calvinhlin/IMSSDC2024/PCB/Full/phi2_50MHz_EPC2214/render.png

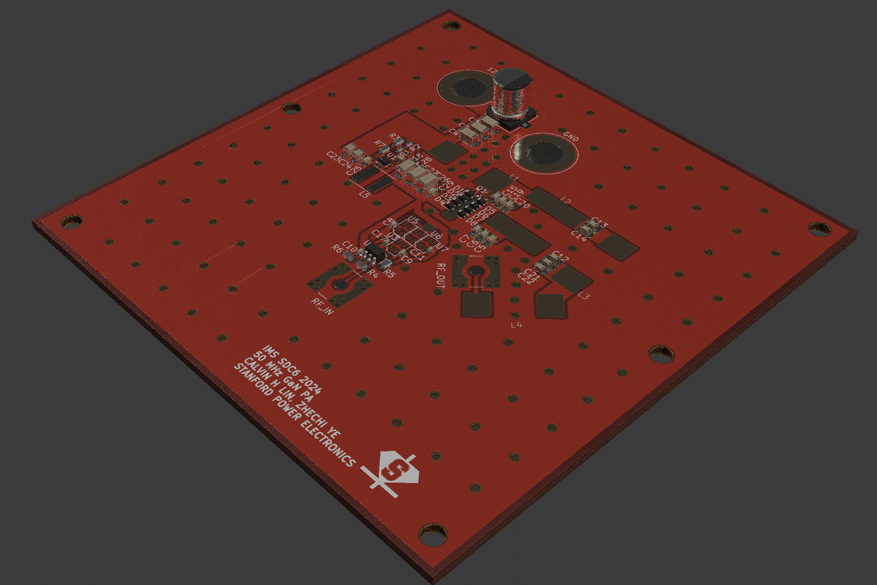
PCB/Full/phi2_50MHz_EPC2214/render.png
