calvinhlin/IMSSDC2024/Measurement Data/GaN_thermal.pdf

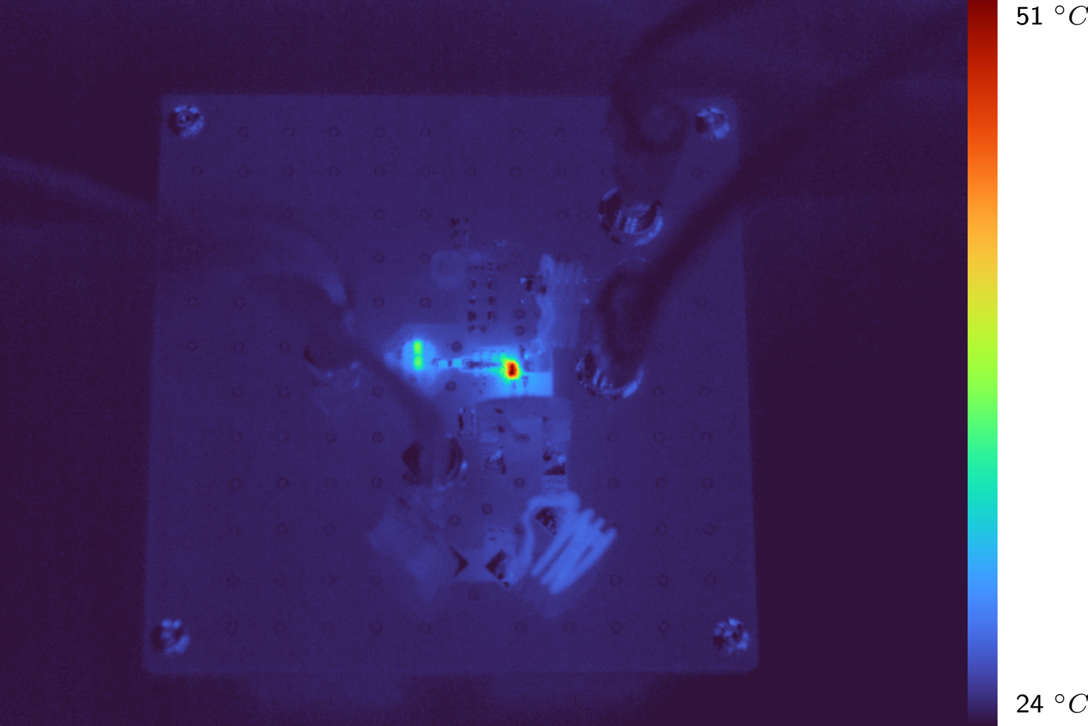
[picture p15: page 1]

24 ◦C

51 ◦C
