calvinhlin/IMSSDC2024/Measurement Data/ims24drain_rev2.csv

3.13E-07 | 2.44E+01
3.13E-07 | 2.43E+01
3.13E-07 | 2.43E+01
3.13E-07 | 2.42E+01
3.13E-07 | 2.42E+01
3.13E-07 | 2.41E+01
3.13E-07 | 2.41E+01
3.13E-07 | 2.40E+01
3.13E-07 | 2.40E+01
3.13E-07 | 2.39E+01
3.13E-07 | 2.38E+01
3.13E-07 | 2.38E+01
3.13E-07 | 2.37E+01
3.13E-07 | 2.36E+01
3.13E-07 | 2.35E+01
3.13E-07 | 2.35E+01
3.13E-07 | 2.34E+01
3.13E-07 | 2.33E+01
3.13E-07 | 2.31E+01
3.13E-07 | 2.30E+01
3.13E-07 | 2.29E+01
3.13E-07 | 2.27E+01
3.13E-07 | 2.26E+01
3.13E-07 | 2.24E+01
3.13E-07 | 2.22E+01
3.13E-07 | 2.21E+01
3.13E-07 | 2.19E+01
3.13E-07 | 2.17E+01
3.13E-07 | 2.15E+01
3.13E-07 | 2.13E+01
3.13E-07 | 2.12E+01
3.13E-07 | 2.10E+01
3.13E-07 | 2.09E+01
3.13E-07 | 2.07E+01
3.13E-07 | 2.06E+01
3.13E-07 | 2.04E+01
3.13E-07 | 2.03E+01
3.13E-07 | 2.02E+01
3.13E-07 | 2.01E+01
3.13E-07 | 2.00E+01
3.13E-07 | 1.99E+01
3.13E-07 | 1.98E+01
3.13E-07 | 1.97E+01
3.13E-07 | 1.96E+01
3.13E-07 | 1.96E+01
3.13E-07 | 1.95E+01
3.13E-07 | 1.95E+01
3.13E-07 | 1.95E+01
3.13E-07 | 1.94E+01
3.13E-07 | 1.94E+01
3.13E-07 | 1.94E+01
3.13E-07 | 1.94E+01
3.13E-07 | 1.93E+01
3.13E-07 | 1.93E+01
3.13E-07 | 1.93E+01
3.13E-07 | 1.92E+01
3.13E-07 | 1.92E+01
3.13E-07 | 1.91E+01
3.13E-07 | 1.91E+01
3.13E-07 | 1.90E+01
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
