calvinhlin/IMSSDC2024/Measurement Data/ims24gate_rev2.csv

3.13E-07 | -6.83E-01 | 0.00E+00
3.13E-07 | -6.62E-01 | 3.12E-12
3.13E-07 | -6.49E-01 | 6.25E-12
3.13E-07 | -6.30E-01 | 9.37E-12
3.13E-07 | -6.20E-01 | 1.25E-11
3.13E-07 | -6.04E-01 | 1.56E-11
3.13E-07 | -5.88E-01 | 1.87E-11
3.13E-07 | -5.78E-01 | 2.19E-11
3.13E-07 | -5.65E-01 | 2.50E-11
3.13E-07 | -5.51E-01 | 2.81E-11
3.13E-07 | -5.44E-01 | 3.12E-11
3.13E-07 | -5.30E-01 | 3.44E-11
3.13E-07 | -5.30E-01 | 3.75E-11
3.13E-07 | -5.25E-01 | 4.06E-11
3.13E-07 | -5.22E-01 | 4.37E-11
3.13E-07 | -5.12E-01 | 4.69E-11
3.13E-07 | -5.12E-01 | 5.00E-11
3.13E-07 | -5.12E-01 | 5.31E-11
3.13E-07 | -5.12E-01 | 5.62E-11
3.13E-07 | -5.12E-01 | 5.94E-11
3.13E-07 | -5.17E-01 | 6.25E-11
3.13E-07 | -5.15E-01 | 6.56E-11
3.13E-07 | -5.17E-01 | 6.87E-11
3.13E-07 | -5.22E-01 | 7.19E-11
3.13E-07 | -5.20E-01 | 7.50E-11
3.13E-07 | -5.30E-01 | 7.81E-11
3.13E-07 | -5.33E-01 | 8.12E-11
3.13E-07 | -5.38E-01 | 8.44E-11
3.13E-07 | -5.44E-01 | 8.75E-11
3.13E-07 | -5.44E-01 | 9.06E-11
3.13E-07 | -5.49E-01 | 9.37E-11
3.13E-07 | -5.49E-01 | 9.69E-11
3.13E-07 | -5.49E-01 | 1.00E-10
3.13E-07 | -5.57E-01 | 1.03E-10
3.13E-07 | -5.57E-01 | 1.06E-10
3.13E-07 | -5.59E-01 | 1.09E-10
3.13E-07 | -5.59E-01 | 1.12E-10
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
