calvinhlin/IMSSDC2024/Measurement Data/ims24output_rev2.csv

3.13E-07 | -2.69E+01
3.13E-07 | -2.68E+01
3.13E-07 | -2.68E+01
3.13E-07 | -2.67E+01
3.13E-07 | -2.67E+01
3.13E-07 | -2.66E+01
3.13E-07 | -2.65E+01
3.13E-07 | -2.65E+01
3.13E-07 | -2.64E+01
3.13E-07 | -2.63E+01
3.13E-07 | -2.63E+01
3.13E-07 | -2.62E+01
3.13E-07 | -2.62E+01
3.13E-07 | -2.62E+01
3.13E-07 | -2.62E+01
3.13E-07 | -2.62E+01
3.13E-07 | -2.62E+01
3.13E-07 | -2.62E+01
3.13E-07 | -2.62E+01
3.13E-07 | -2.62E+01
3.13E-07 | -2.63E+01
3.13E-07 | -2.63E+01
3.13E-07 | -2.64E+01
3.13E-07 | -2.65E+01
3.13E-07 | -2.65E+01
3.13E-07 | -2.66E+01
3.13E-07 | -2.67E+01
3.13E-07 | -2.68E+01
3.13E-07 | -2.69E+01
3.13E-07 | -2.70E+01
3.13E-07 | -2.70E+01
3.13E-07 | -2.71E+01
3.13E-07 | -2.72E+01
3.13E-07 | -2.72E+01
3.13E-07 | -2.73E+01
3.13E-07 | -2.73E+01
3.13E-07 | -2.73E+01
3.13E-07 | -2.73E+01
3.13E-07 | -2.73E+01
3.13E-07 | -2.73E+01
3.13E-07 | -2.72E+01
3.13E-07 | -2.72E+01
3.13E-07 | -2.71E+01
3.13E-07 | -2.71E+01
3.13E-07 | -2.70E+01
3.13E-07 | -2.69E+01
3.13E-07 | -2.68E+01
3.13E-07 | -2.67E+01
3.13E-07 | -2.66E+01
3.13E-07 | -2.64E+01
3.13E-07 | -2.63E+01
3.13E-07 | -2.62E+01
3.13E-07 | -2.61E+01
3.13E-07 | -2.60E+01
3.13E-07 | -2.59E+01
3.13E-07 | -2.59E+01
3.13E-07 | -2.58E+01
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
