calvinhlin/IMSSDC2024/Measurement Data/ims24drain_rev1.csv

 | Time | Voltage
1.32E-06 | 0.00E+00 | 2.26E+01
1.32E-06 | 6.30E-06 | 2.26E+01
1.32E-06 | 1.25E-05 | 2.26E+01
1.32E-06 | 1.88E-05 | 2.26E+01
1.32E-06 | 2.50E-05 | 2.25E+01
1.32E-06 | 3.13E-05 | 2.25E+01
1.32E-06 | 3.75E-05 | 2.25E+01
1.32E-06 | 4.38E-05 | 2.25E+01
1.32E-06 | 5.00E-05 | 2.25E+01
1.32E-06 | 5.63E-05 | 2.25E+01
1.32E-06 | 6.25E-05 | 2.25E+01
1.32E-06 | 6.88E-05 | 2.24E+01
1.32E-06 | 7.50E-05 | 2.24E+01
1.32E-06 | 8.13E-05 | 2.24E+01
1.32E-06 | 8.75E-05 | 2.24E+01
1.32E-06 | 9.38E-05 | 2.24E+01
1.32E-06 | 1.00E-04 | 2.24E+01
1.32E-06 | 1.06E-04 | 2.23E+01
1.32E-06 | 1.12E-04 | 2.23E+01
1.32E-06 | 1.19E-04 | 2.23E+01
1.32E-06 | 1.25E-04 | 2.22E+01
1.32E-06 | 1.31E-04 | 2.22E+01
1.32E-06 | 1.38E-04 | 2.22E+01
1.32E-06 | 1.44E-04 | 2.21E+01
1.32E-06 | 1.50E-04 | 2.21E+01
1.32E-06 | 1.56E-04 | 2.20E+01
1.32E-06 | 1.62E-04 | 2.19E+01
1.32E-06 | 1.69E-04 | 2.19E+01
1.32E-06 | 1.75E-04 | 2.18E+01
1.32E-06 | 1.81E-04 | 2.17E+01
1.32E-06 | 1.88E-04 | 2.17E+01
1.32E-06 | 1.94E-04 | 2.16E+01
1.32E-06 | 2.00E-04 | 2.15E+01
1.32E-06 | 2.06E-04 | 2.14E+01
1.32E-06 | 2.12E-04 | 2.14E+01
1.32E-06 | 2.19E-04 | 2.13E+01
1.32E-06 | 2.25E-04 | 2.12E+01
1.32E-06 | 2.31E-04 | 2.12E+01
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
