calvinhlin/IMSSDC2024/Measurement Data/ims24gate_rev1.csv

1.32E-06 | 0.00E+00 | 5.62E+00
1.32E-06 | 6.30E-06 | 5.61E+00
1.32E-06 | 1.25E-05 | 5.60E+00
1.32E-06 | 1.88E-05 | 5.60E+00
1.32E-06 | 2.50E-05 | 5.59E+00
1.32E-06 | 3.13E-05 | 5.58E+00
1.32E-06 | 3.75E-05 | 5.57E+00
1.32E-06 | 4.38E-05 | 5.56E+00
1.32E-06 | 5.00E-05 | 5.55E+00
1.32E-06 | 5.63E-05 | 5.54E+00
1.32E-06 | 6.25E-05 | 5.54E+00
1.32E-06 | 6.88E-05 | 5.53E+00
1.32E-06 | 7.50E-05 | 5.52E+00
1.32E-06 | 8.13E-05 | 5.52E+00
1.32E-06 | 8.75E-05 | 5.51E+00
1.32E-06 | 9.38E-05 | 5.51E+00
1.32E-06 | 1.00E-04 | 5.50E+00
1.32E-06 | 1.06E-04 | 5.50E+00
1.32E-06 | 1.12E-04 | 5.49E+00
1.32E-06 | 1.19E-04 | 5.48E+00
1.32E-06 | 1.25E-04 | 5.47E+00
1.32E-06 | 1.31E-04 | 5.46E+00
1.32E-06 | 1.37E-04 | 5.46E+00
1.32E-06 | 1.44E-04 | 5.45E+00
1.32E-06 | 1.50E-04 | 5.44E+00
1.32E-06 | 1.56E-04 | 5.43E+00
1.32E-06 | 1.62E-04 | 5.41E+00
1.32E-06 | 1.69E-04 | 5.40E+00
1.32E-06 | 1.75E-04 | 5.39E+00
1.32E-06 | 1.81E-04 | 5.38E+00
1.32E-06 | 1.88E-04 | 5.37E+00
1.32E-06 | 1.94E-04 | 5.35E+00
1.32E-06 | 2.00E-04 | 5.34E+00
1.32E-06 | 2.06E-04 | 5.33E+00
1.32E-06 | 2.12E-04 | 5.32E+00
1.32E-06 | 2.19E-04 | 5.31E+00
1.32E-06 | 2.25E-04 | 5.30E+00
1.32E-06 | 2.31E-04 | 5.29E+00
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
