calvinhlin/IMSSDC2024/Measurement Data/ims24output_rev1.csv

 | Time (Output Voltage) | Output Voltage | -1.00E-02 |  | Drain Voltage | Time (Gate Voltage) | Time (Gate Voltage) | Gate Voltage
1.32E-06 | 0.00E+00 | 2.48E+01 | -1.00E-02 | 0.00E+00 | 2.26E+01 | 0.00E+00 | 0.00E+00 | 5.62E+00 | 0
1.32E-06 | 6.20E-06 | 2.49E+01 | -9.99E-03 | 6.30E-06 | 2.26E+01 | 6.30E-06 | 6.30E-06 | 5.61E+00
1.32E-06 | 1.25E-05 | 2.50E+01 | -9.99E-03 | 1.25E-05 | 2.26E+01 | 1.25E-05 | 1.25E-05 | 5.60E+00
1.32E-06 | 1.87E-05 | 2.50E+01 | -9.98E-03 | 1.88E-05 | 2.26E+01 | 1.88E-05 | 1.88E-05 | 5.60E+00
1.32E-06 | 2.50E-05 | 2.51E+01 | -9.98E-03 | 2.50E-05 | 2.25E+01 | 2.50E-05 | 2.50E-05 | 5.59E+00
1.32E-06 | 3.12E-05 | 2.52E+01 | -9.97E-03 | 3.13E-05 | 2.25E+01 | 3.13E-05 | 3.13E-05 | 5.58E+00
1.32E-06 | 3.75E-05 | 2.53E+01 | -9.96E-03 | 3.75E-05 | 2.25E+01 | 3.75E-05 | 3.75E-05 | 5.57E+00
1.32E-06 | 4.37E-05 | 2.54E+01 | -9.96E-03 | 4.38E-05 | 2.25E+01 | 4.38E-05 | 4.38E-05 | 5.56E+00
1.32E-06 | 5.00E-05 | 2.55E+01 | -9.95E-03 | 5.00E-05 | 2.25E+01 | 5.00E-05 | 5.00E-05 | 5.55E+00
1.32E-06 | 5.62E-05 | 2.55E+01 | -9.94E-03 | 5.63E-05 | 2.25E+01 | 5.63E-05 | 5.63E-05 | 5.54E+00
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
