calvinhlin/IMSSDC2024/Measurement Data/vdrain_rev2.tif

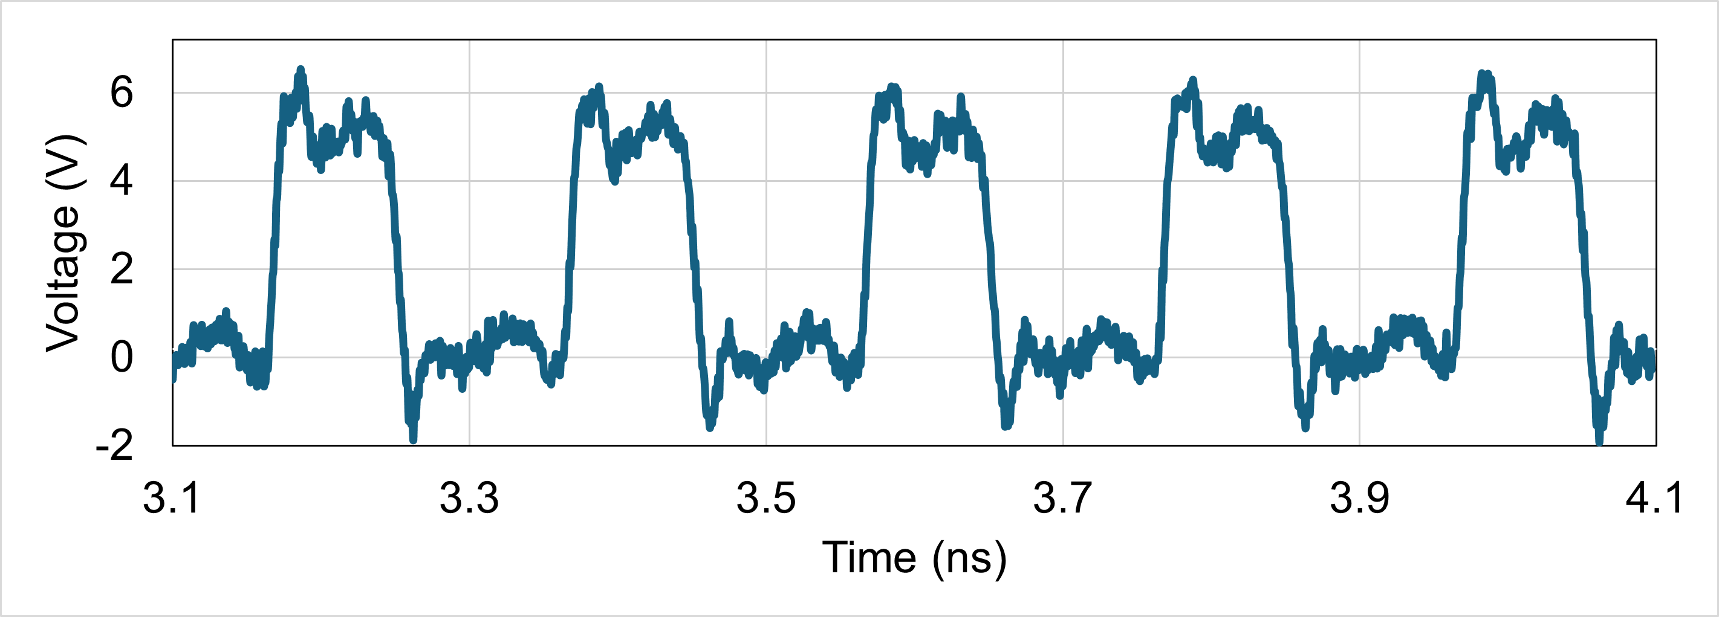
Measurement Data/vdrain_rev2.tif
