calvinhlin/IMSSDC2024/Measurement Data/ims24drain_rev1.pdf

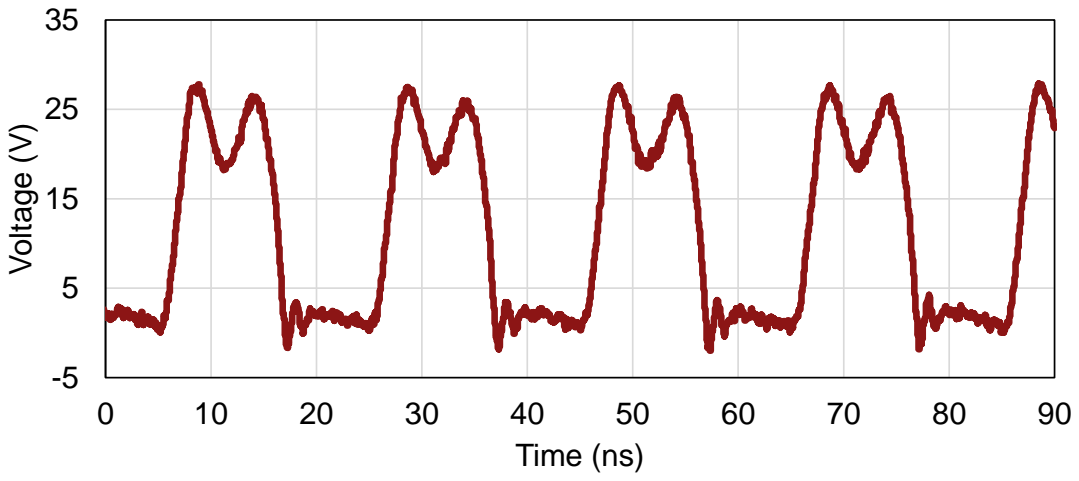
[picture p17: page 1]
Voltage (V); Time (ns)
