calvinhlin/IMSSDC2024/Measurement Data/ims24gate_rev2.pdf

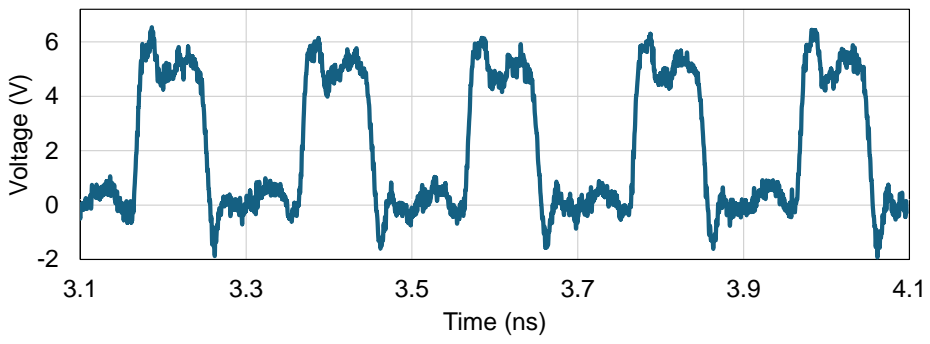
[picture p18: page 1]
Voltage (V); Time (ns)
