calvinhlin/IMSSDC2024/Measurement Data/ims24output_rev1.pdf

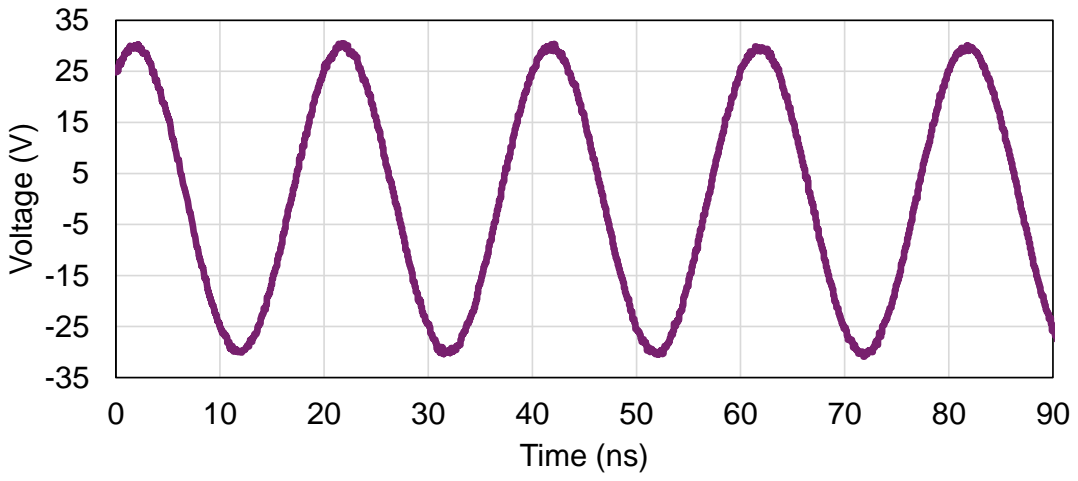
[picture p19: page 1]
Voltage (V); Time (ns)
