calvinhlin/IMSSDC2024/Docs/firstreport.pdf

# 50 MHz GaN Based Power Amplifier with Digital Resonant Gate Drive

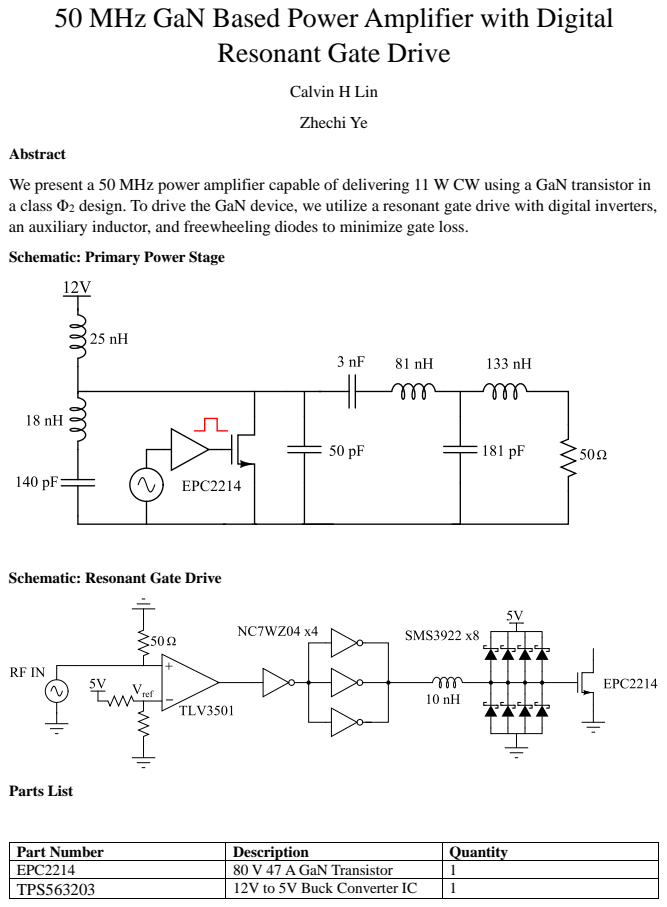
[picture p20: page 1]
Calvin H Lin Zhechi Ye; Parts List

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

Schematic: Resonant Gate Drive

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

Constructed Circuit

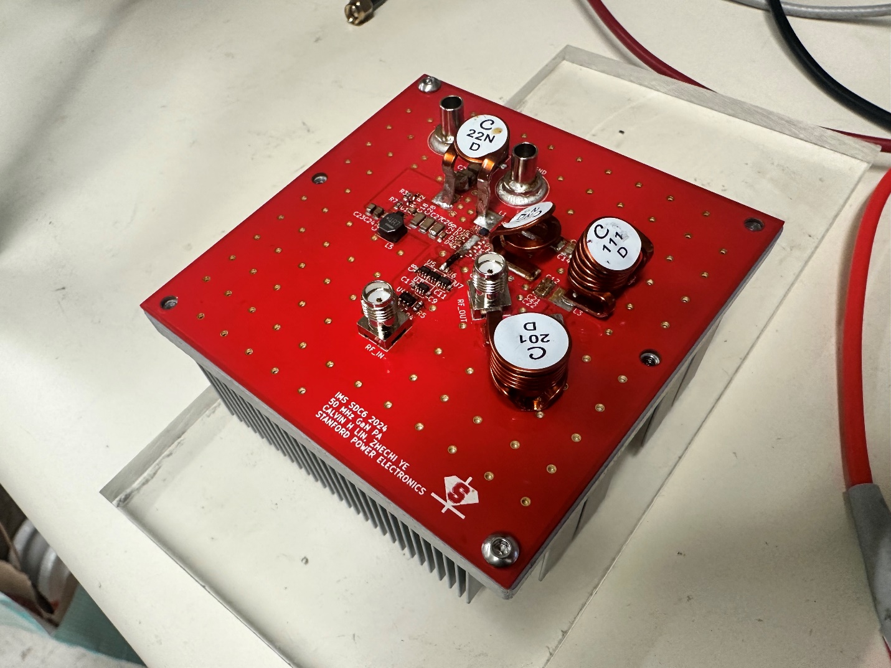
[picture p21: figure]

We are still in the process of tuning the power stage, and will update this report with results as soon as they are complete.
