calvinhlin/IMSSDC2024/Measurement Data/spice_drain_left_right.pdf

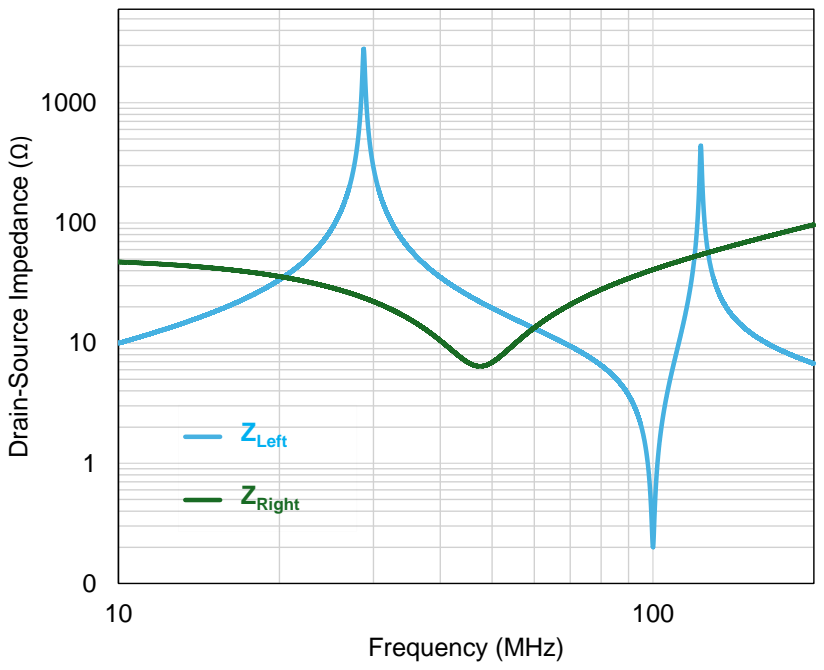
[picture p22: page 1]
Frequency (MHz); ZLeft ZRight

Drain-Source Impedance (Ω)
