calvinhlin/IMSSDC2024/Measurement Data/spice_drain_parallel.pdf

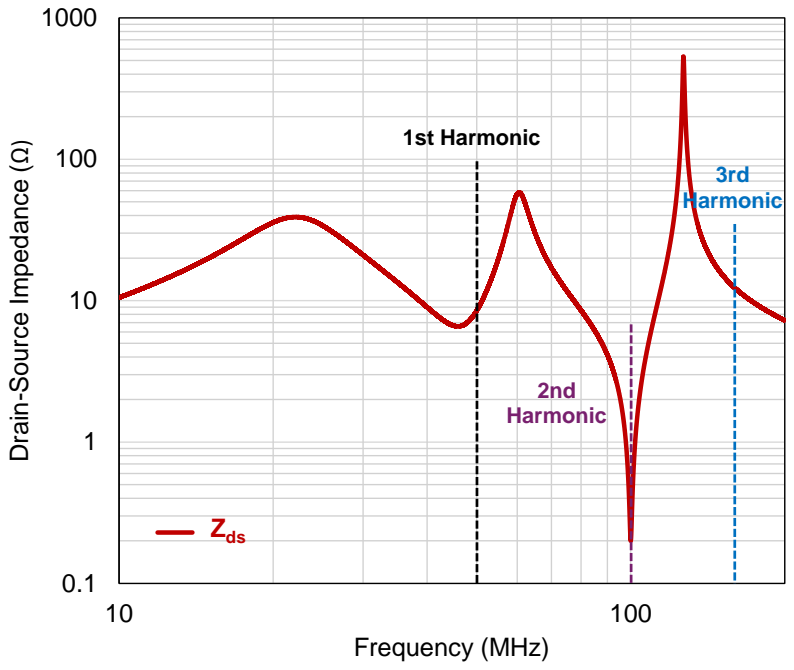
[picture p23: page 1]
Frequency (MHz); 1st Harmonic; 3rd Harmonic; Zds

Drain-Source Impedance (

2nd
Harmonic
