calvinhlin/IMSSDC2024/Measurement Data/ims24spectrum_rev2.pdf

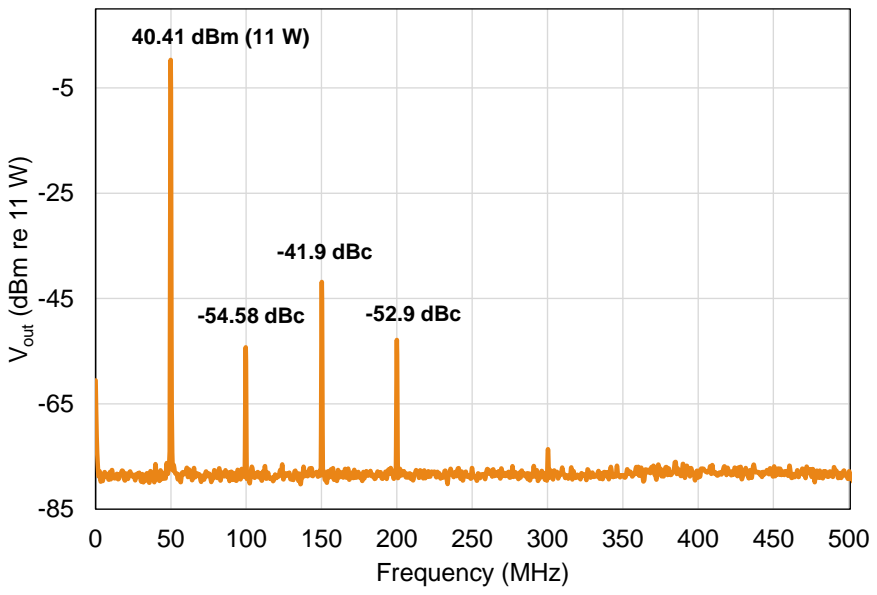
[picture p24: page 1]
Frequency (MHz); 40.41 dBm (11 W)

Vout (dBm re 11 W)

-41.9 dBc

-54.58 dBc | | -52.9 dBc
