calvinhlin/IMSSDC2024/SPICE/phi_2/spice_drain_parallel.pdf

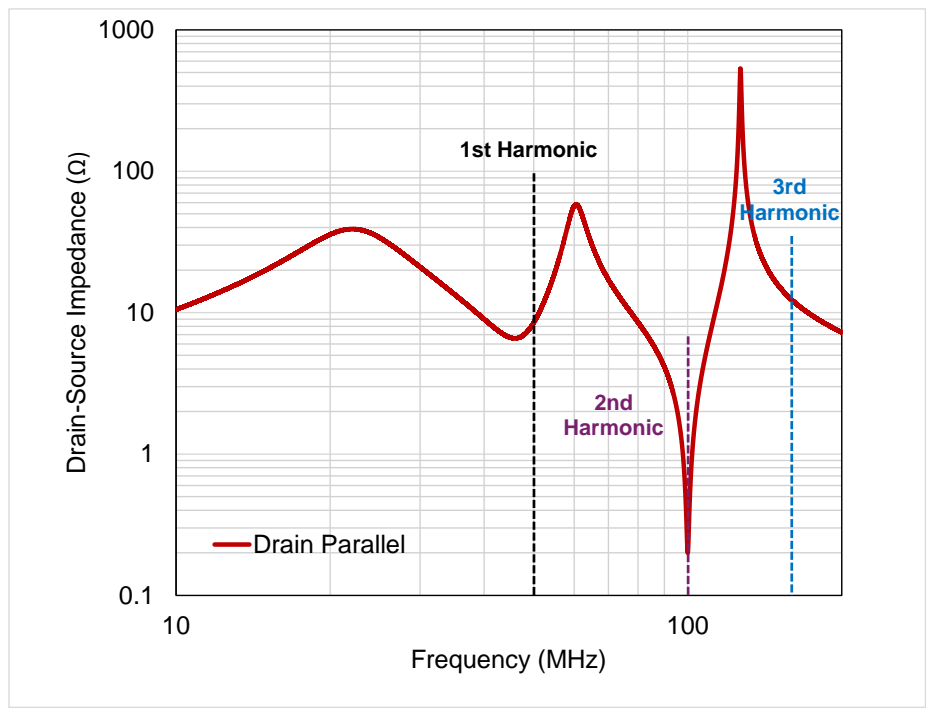
[picture p25: page 1]
Frequency (MHz); Drain Parallel; 1st Harmonic; 3rd Harmonic

Drain-Source Impedance (

2nd
Harmonic
