calvinhlin/IMSSDC2024/SPICE/phi_2/spice_rain_parallel.pdf

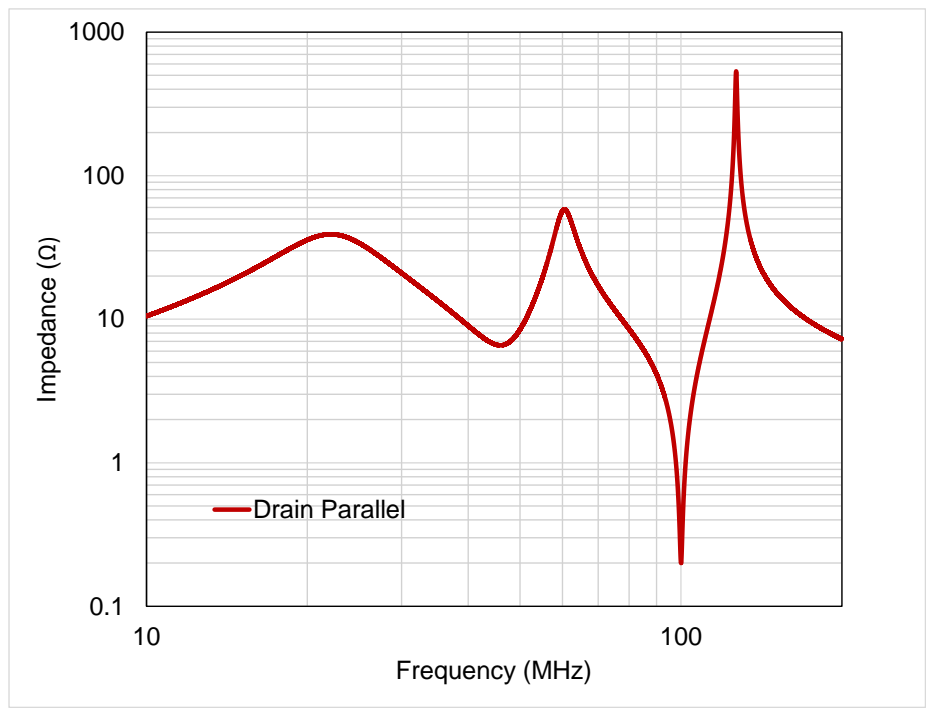
[picture p26: page 1]
Impedance (; Frequency (MHz); Drain Parallel
