calvinhlin/IMSSDC2024/Measurement Data/ims24gate_rev1.pdf

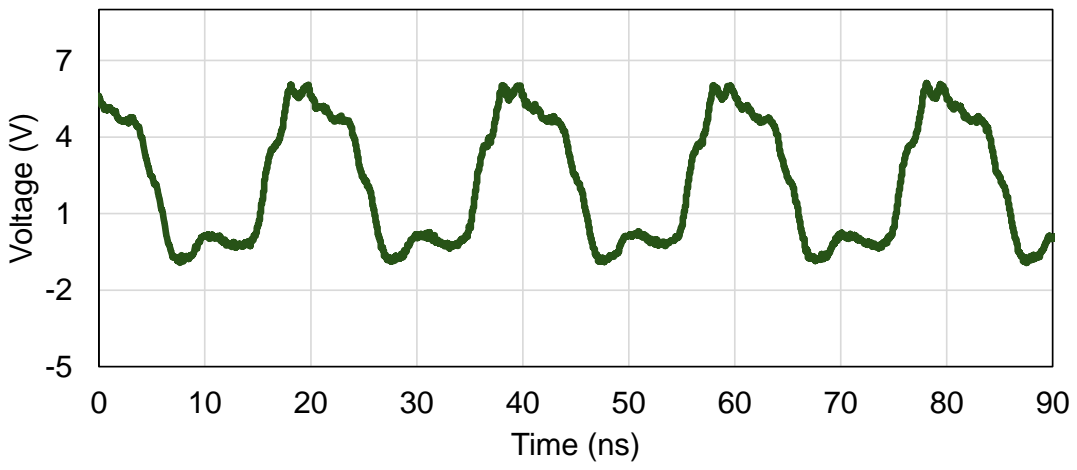
[picture p27: page 1]
Voltage (V); Time (ns)
