calvinhlin/IMSSDC2024/SPICE/phi_2/phi_2_50MHz_EPC8010.asc

C1: cap; {Cmr}
C2: cap; {Cp}
C3: cap; 4n
C4: cap; {CM1}
C5: cap; {CM1}
C6: cap; {CM2}
C7: cap; {CM1}
I1: current; ""; AC 1
I2: current; ""; AC 1
I3: current; ""; AC 1
I4: current; ""; AC 1
L1: ind; {Lf}; Rser={ESR}
L2: ind; {Lmr}; Rser={ESR}
L3: ind; {LS1}; Rser={ESR}
L4: ind; {LS}
L5: ind; {LL}; Rser={ESR}
L6: ind; {LS}
L7: ind; {LL}; Rser={ESR}
L8: ind; {LS}
L9: ind; {LL1}; Rser={ESR}
L10: ind; {LS}
L11: ind; {LL}; Rser={ESR}
R1: res; 50
RL1: res; 50
RL: res; 50
U1: EPCGaN; EPC8010
V1: voltage; PULSE(0 6 0 0.5n 0.5n {D/f} {1/f})
VDC1: voltage; 12
Named nets: 12V, G1, 0, DRAIN, OUT, zout
.param f=50Meg D=0.35 ESR=0.2
.param LS1=17n
.tran 0 {2000/f} {1996/f}
.lib EPCGaNLibrary.lib
.ac dec 100k 10MEG 200MEG
.meas TRAN Pin AVG I(L1)*V(12V)
.meas TRAN Pout AVG I(RL)*V(OUT)
.meas TRAN PG AVG -V(G1)*I(V1)
.meas TRAN EFFICIENCY PARAM POUT/(PIN+PG)
.param CM1=181p LS=63.7n LL=133.16n
.param Lf=140n Lmr=37.4n Cmr=67.7p Cp=90p
.param CM2 = 159p LL1 = 1/({CM2}*(2*PI*38.13Meg)**2)
