calvinhlin/IMSSDC2024/SPICE/phi_2/phi_2_50MHz_EPC2014C.asc

C1: cap; {Cmr}
C2: cap; {Cp}
C3: cap; 3.38n
C4: cap; {CM1}
L1: ind; {Lf}; Rser={ESR}
L2: ind; {Lmr}; Rser={ESR}
L3: ind; {LS1}; Rser={ESR}
L4: ind; {LS}
L5: ind; {LL}
R1: res; 1m
R2: res; 10
RL: res; 50
U1: EPCGaN; EPC2014C
V1: voltage; PULSE(0 6 0 1n 1n {D/f} {1/f})
V2: voltage; ""; AC 1
V4: voltage; 25
VDC1: voltage; 12
Named nets: 12V, G1, 0, OUT, DRAIN, tc
.param f=50Meg D=0.33 ESR=0.2
.param LS1=17n
.tran 0 {500/f} {496/f}
.lib EPCGaNLibrary.lib
.param Lf=25n Lmr=18n Cmr=140p Cp=50p
.ac dec 3000 10MEG 300MEG
.param LS = 111.4n CM1=116p LL=258.6n
.meas TRAN Pin AVG I(L1)*V(12V)
.meas TRAN Pout AVG I(RL)*V(OUT)
.meas TRAN PG AVG -V(G1)*I(V1)
.meas TRAN EFFICIENCY PARAM POUT/(PIN+PG)
