calvinhlin/IMSSDC2024/SPICE/phi_2/phi_2_50MHz_EPC2070.asc

C1: cap; {Cmr}
C2: cap; {Cp}
C3: cap; 3n
C4: cap; {CM1}
C5: cap; {CM2}
L1: ind; {Lf}; Rser={ESR}
L2: ind; {Lmr}; Rser={ESR}
L3: ind; {LS}; Rser={ESR}
L4: ind; {LM1}
L5: ind; {LM2}; Rser={ESR}
R1: res; 1m
R2: res; 10
RL: res; 50
U1: EPCGaN; EPC2070
V1: voltage; PULSE(0 6 0 1n 1n {D/f} {1/f})
V2: voltage; ""; AC 1
V4: voltage; 25
VDC1: voltage; 12
Named nets: 12V, G1, 0, OUT, DRAIN, tc
.param f=50Meg D=0.33 ESR=0.2
.param LS=17n
.tran 0 {500/f} {496/f}
.lib EPCGaNLibrary.lib
.param Lf=30n Lmr=18n Cmr=140p Cp=75p
.ac dec 3000 10MEG 300MEG
.param LM1=23n CM1=307p LM2=74n CM2=95p
.meas TRAN Pin AVG I(L1)*V(12V)
.meas TRAN Pout AVG I(RL)*V(OUT)
.meas TRAN PG AVG -V(G1)*I(V1)
.meas TRAN EFFICIENCY PARAM POUT/(PIN+PG)
