calvinhlin/IMSSDC2024/SPICE/phi_2/phi_2_50MHz_GS61004B.asc

C1: cap; {Cmr}
C2: cap; {Cp}
C3: cap; 3n
C4: cap; {CM1}
I1: current; ""; AC 1
L1: ind; {Lf}; Rser={ESR}
L2: ind; {Lmr}; Rser={ESR}
L3: ind; {LS1}; Rser={ESR}
L4: ind; {LS}
L5: ind; {LL}; Rser={ESR}
R2: res; 10
RL: res; 50
U1: GaN_LTspice_GS61004B_L3V4P2
V1: voltage; PULSE(0 6 0 0.5n 0.5n {D/f} {1/f})
V4: voltage; 25
VDC1: voltage; 12
Named nets: 12V, G1, 0, DRAIN, tj, tc, OUT
.param f=50Meg D=0.3 ESR=0.2
.tran 0 {500/f} {496/f}
.lib EPCGaNLibrary.lib
.ac dec 3000 10MEG 300MEG
.meas TRAN Pin AVG I(L1)*V(12V)
.meas TRAN Pout AVG I(RL)*V(OUT)
.meas TRAN PG AVG -V(G1)*I(V1)
.meas TRAN EFFICIENCY PARAM POUT/(PIN+PG)
.param LS1=17n
.param Lf=25n Lmr=18n Cmr=140p Cp=10p
.param LS = 111.4n CM1=116p LL=258.6n
