calvinhlin/IMSSDC2024/SPICE/phi_2/phi_2_50MHz_IGLR60R260D1.asc

C1: cap; {Cmr}
C2: cap; {Cp}
C3: cap; 3n
C4: cap; {CM1}
C5: cap; {CM2}
I1: current; ""; AC 1
L1: ind; {Lf}; Rser={ESR}
L2: ind; {Lmr}; Rser={ESR}
L3: ind; {LS}; Rser={ESR}
L4: ind; {LM1}
L5: ind; {LM2}; Rser={ESR}
R2: res; 10
RL: res; 50
U1: IGLR60R260D1_L1
V1: voltage; PULSE(0 6 0 0.5n 0.5n {D/f} {1/f})
V4: voltage; 25
VDC1: voltage; 12
Named nets: 12V, G1, 0, OUT, DRAIN, tc
.param f=50Meg D=0.3 ESR=0.2
.param LS=17n
.tran 0 {500/f} {496/f}
.lib IFX_CoolGaN_Gen1_600V.lib
.param Lf=35n Lmr=22.5n Cmr=113p Cp=110p
.ac dec 3000 10MEG 300MEG
.param LM1=23n CM1=307p LM2=74n CM2=95p
.meas TRAN Pin AVG I(L1)*V(12V)
.meas TRAN Pout AVG I(RL)*V(OUT)
.meas TRAN PG AVG -V(G1)*I(V1)
.meas TRAN EFFICIENCY PARAM POUT/(PIN+PG)
