calvinhlin/IMSSDC2024/SPICE/gatedriver/gatedriver.asc

B1: bv; V=sdt(I(C1))
C1: cap; 150p
C2: cap; 11p
C3: cap; 11p
C4: cap; 11p
C5: cap; 11p
D1: schottky; RB215T-60
D2: schottky; RB215T-60
D3: schottky; RB215T-60
D4: schottky; RB215T-60
D5: schottky; RB215T-60
D6: schottky; RB215T-60
D7: schottky; RB215T-60
I1: current; 4
I2: current; 4
I3: current; 4
I4: current; 4
I5: current; 4
I6: current; 4
I7: current; 4
R1: res; 3m
R2: res; 50m
R3: res; 1k
R4: res; {Rpullup}
R5: res; {Rpulldown}
R6: res; 3m
R7: res; {Rpullup}
R8: res; {Rpulldown}
S1: sw; SW1
S2: sw; SW2
S3: sw; SW1
S4: sw; SW2
U1: EPCGaN; EPC8004
U2: EPCGaN; EPC2014C
U3: EPCGaN; EPC2070
U4: EPCGaN; EPC2007C
U5: EPCGaN; EPC2214
U6: EPCGaN; EPC2035
U7: EPCGaN; EPC2051
V1: voltage; 5
V2: voltage; PULSE(0 5 0 0.1n 0.1n {0.45/f} {1/f})
V3: voltage; PULSE(0 5 {0.5/f} 0.1n 0.1n {0.45/f} {1/f})
V4: voltage; 40
V5: voltage; 40
V6: voltage; 40
V7: voltage; 40
V8: voltage; 40
V9: voltage; 40
V10: voltage; 40
V11: voltage; 5
V12: voltage; PULSE(0 5 0 10p 10p {0.5/f} {1/f})
V13: voltage; PULSE(0 5 0 10p 10p {0.5/f} {1/f})
V14: voltage; PULSE(0 5 0 10p 10p {0.5/f} {1/f})
V15: voltage; PULSE(0 5 0 10p 10p {0.5/f} {1/f})
V16: voltage; PULSE(0 5 0 10p 10p {0.5/f} {1/f})
V17: voltage; PULSE(0 5 0 10p 10p {0.5/f} {1/f})
V18: voltage; PULSE(0 5 0 10p 10p {0.5/f} {1/f})
Named nets: 0, q1, q2, Q
.param
 
+f = 50Meg
+Rpullup = 1
+Rpulldown = 1
 
.model SW1 SW(Ron = 1m Roff = 1Meg Vt = 0.1)
.model SW2 SW(Ron = 1m Roff = 1Meg Vt = 0.1)
.tran 0 {50/f} {45/f} {1/f/200}
Rth = 8.2
Ciss = 
Coss =
Rth = 3.6
Ciss = 300 pF
Coss = 210 pF
Rth = 3.4
Ciss = 386 pF
Coss = 123 pF
Rth = 3.6
Ciss = 220 pF
Coss = 165 pF
Rth = 2.7
Ciss = 238 pF
Coss = 194 pF
Rth = 6.5
Ciss = 115 pF
COss = 90 pF
Rth = 3.8
Ciss = 297 pF
Coss = 129 pF
Top choices:
 
2051
2014C
2070
 
Maybe 2035?
