calvinhlin/IMSSDC2024/SPICE/gatedriver/Example EPC2001.asc

L1: ind; 10µ; Rser=15m
L2: ind; 100p; Rpar=10
L3: ind; 100p; Rpar=10
L4: ind; 100p; Rpar=10
L5: ind; 100p; Rpar=10
L6: ind; 1n; Rser=1 Rpar=10
L7: ind; 1n; Rser=1 Rpar=10
U1: EPCGaN; EPC2001
U2: EPCGaN; EPC2001
V1: voltage; PULSE(0 5 0 2n 2n {ton} 2000n); Rser=2
V2: voltage; PULSE(0 5 {ton+10n} 2n 2n {2000n-ton-20n} 2000n); Rser=2
V3: voltage; PULSE(0 12 5u 2u); Rser=1m
V4: voltage; PULSE(0 48 0 2u); Rser=2m
Named nets: 0
.tran 50u
Simple 500kHz 48V to 12V buck using EPC2001
Some board layout inductance included to show SW ringing
To use other EPC parts, change EPC part number by right clicking on text:
Change EPC2001 to EPC20XX to select the part of your choice.
Please make sure EPCGaN.asy and EPCGaNlibrary.lib are located in the same directory as your .asc file
.param ton = 510n
