calvinhlin/IMSSDC2024/PCB/Full/phi2_50MHz_EPC8010/phi2_50MHz_EPC8010.kicad_pcb

## KiCad design PCB/Full/phi2_50MHz_EPC8010/phi2_50MHz_EPC8010.kicad_pcb (2024-05-06)

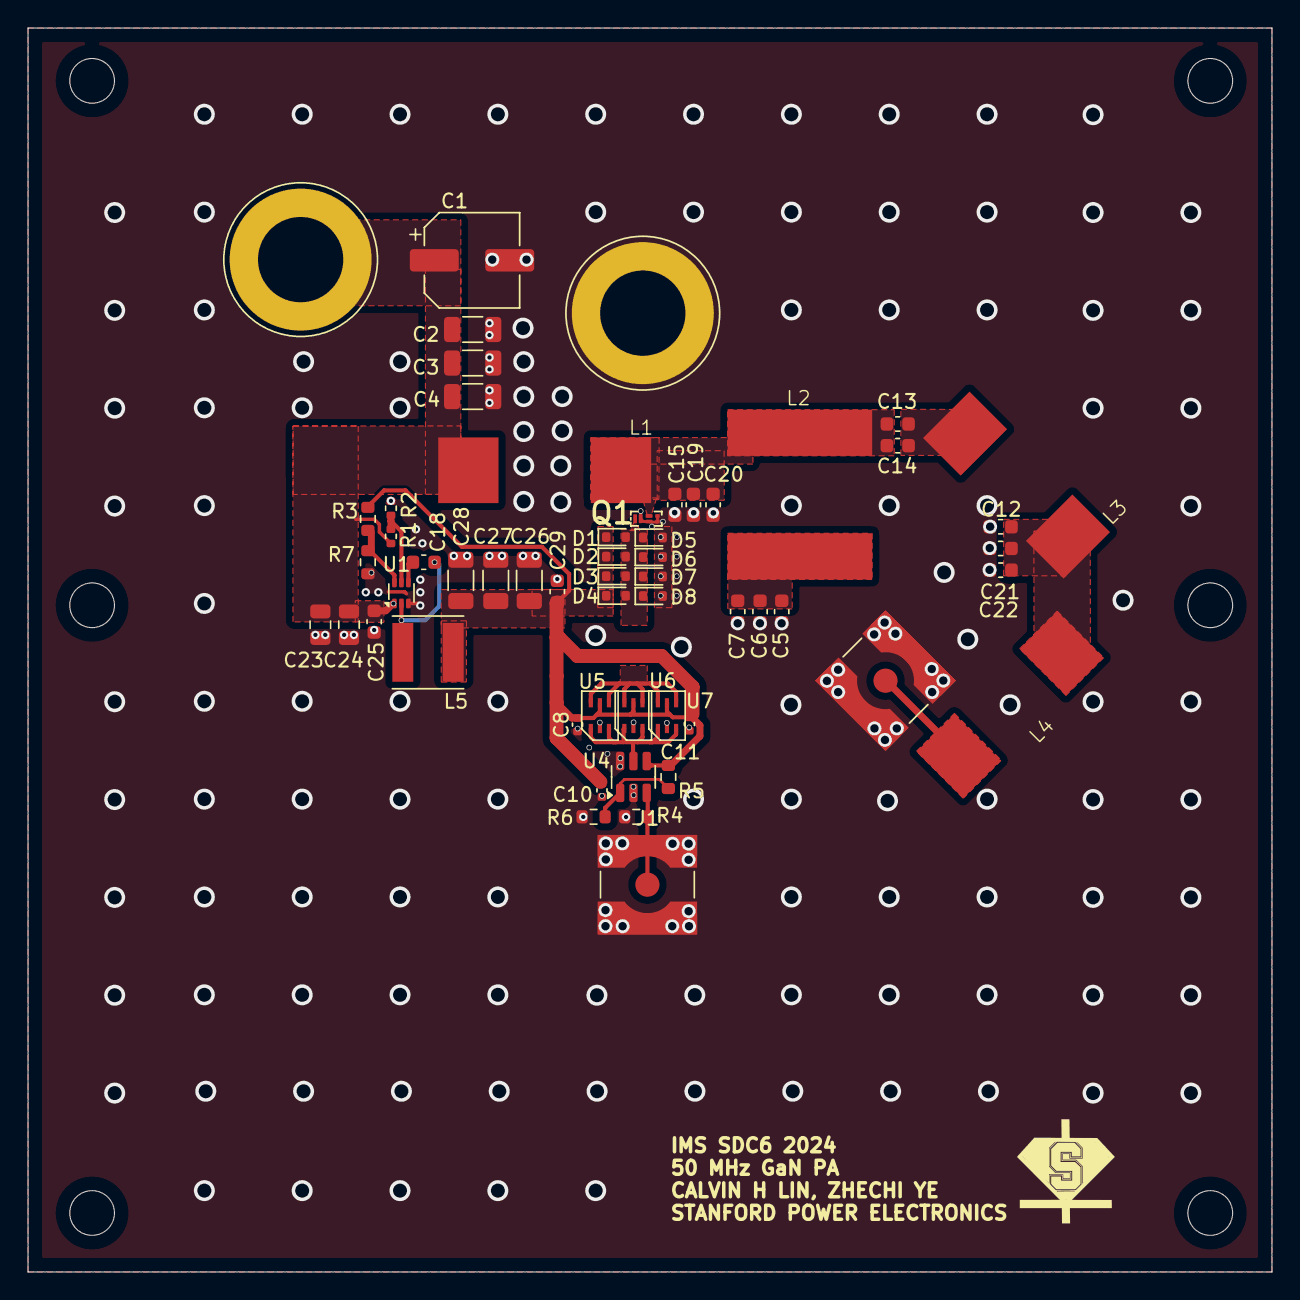
[picture p28: board phi2_50MHz_EPC8010.kicad_pcb from above]

Board: 2 copper layers, 89.0 x 89.0 mm, 56 parts (0 on the bottom side), 17 nets.

Parts:
C1: C_Small; CP_Elec_6.3x7.7
C2, C3, C4: C_Small; C_1206_3216Metric
C5, C6, C7, C12, C13, C14, C15, C19, C20, C21, C22: C; C_0603_1608Metric
C8, C11: C; C_0402_1005Metric
C10: C_Small; C_0402_1005Metric
C18: 0.1u; C_0603_1608Metric
C23, C24: 10u; C_0805_2012Metric
C25, C29: 100n; C_0603_1608Metric
C26, C27, C28: 22u; C_1206_3216Metric
D1, D2, D3, D4, D5, D6, D7, D8: SMS3922; D_SOD-523
J1: RF_IN; SMA_Amphenol_132134-10_Vertical
J2: RF_OUT; SMA_Amphenol_132134-10_Vertical
J5, J6: Conn_01x01_Pin; Banana_Jack_1Pin
L1: 25n; L_Coilcraft_ZA9423
L2: 18n; Coilcraft_1212VS
L3: 81n; Coilcraft_2014VS
L4: 133n; Coilcraft_2014VS
L5: 4.7u; L_Taiyo-Yuden_MD-5050
Q1: EPC8010; D0221
R1: 100k; R_0402_1005Metric
R2: 15k; R_0402_1005Metric
R3: 220k; R_0603_1608Metric
R4: 50; R_0603_1608Metric
R5: OPEN; R_0603_1608Metric
R6: SHORT; R_0603_1608Metric
R7: 30k; R_0603_1608Metric
U1: TPS563203; SOT-563
U4: TLV3501; SOT-23-6
U5, U6, U7: NC7WZ16; nc7wz04_sc-88_SOIC-6

Connections:
+5V: C8.2, C10.1, C11.2, C26.1, C27.1, C28.1, C29.1, D1.1 (K), D2.1 (K), D3.1 (K), D4.1 (K), L5.2, R3.1, R5.1, U4.4 (V+), U5.5 (VCC), U6.5 (VCC), U7.5 (VCC)
+12V: C1.1, C2.1, C3.1, C4.1, C23.1, C24.1, C25.1, J5.1, L1.1, R1.1, U1.1 (VIN)
/D: C13.1, C14.1, C15.1, C19.1, C20.1, L1.2, L2.1, Q1.4 (D)
/G: D1.2 (A), D2.2 (A), D3.2 (A), D4.2 (A), D5.1 (K), D6.1 (K), D7.1 (K), D8.1 (K), Q1.1 (G)
/G1: U5.4 (Y2), U5.6 (Y1), U6.4 (Y2), U6.6 (Y1), U7.4 (Y2), U7.6 (Y1)
/RF_IN: J1.1 (In), R4.2, U4.3 (+IN)
/RF_OUT: J2.1 (In), L4.2
GND: C1.2, C2.2, C3.2, C4.2, C5.2, C6.2, C7.2, C8.1, C10.2, C11.1, C12.2, C15.2, C19.2, C20.2, C21.2, C22.2, C23.2, C24.2, C25.2, C26.2, C27.2, C28.2, C29.2, D5.2 (A), D6.2 (A), D7.2 (A), D8.2 (A), J1.2 (Ext), J2.2 (Ext), J6.1, Q1.2 (SG), Q1.3 (SP1), Q1.5 (SP2), Q1.6 (Sub), R2.2, R4.1, R6.2, R7.2, U1.3 (GND), U4.2 (V-), U4.6 (SHDN), U5.2 (GND), U6.2 (GND), U7.2 (GND)
unnamed: C5.1, C6.1, C7.1, L2.2
unnamed: C12.1, C21.1, C22.1, L3.2, L4.1
unnamed: C13.2, C14.2, L3.1
unnamed: C18.2, U1.4 (BST)
unnamed: R1.2, R2.1, U1.5 (EN)
unnamed: R3.2, R7.1, U1.6 (FB)
unnamed: C18.1, L5.1, U1.2 (SW)
unnamed: R5.2, R6.1, U4.1 (-IN)
unnamed: U4.5 (OUT), U5.1 (A1), U5.3 (A2), U6.1 (A1), U6.3 (A2), U7.1 (A1), U7.3 (A2)
