calvinhlin/IMSSDC2024/PCB/GD_test/GD_test.kicad_pcb

## KiCad design PCB/GD_test/GD_test.kicad_pcb (2024-03-13)

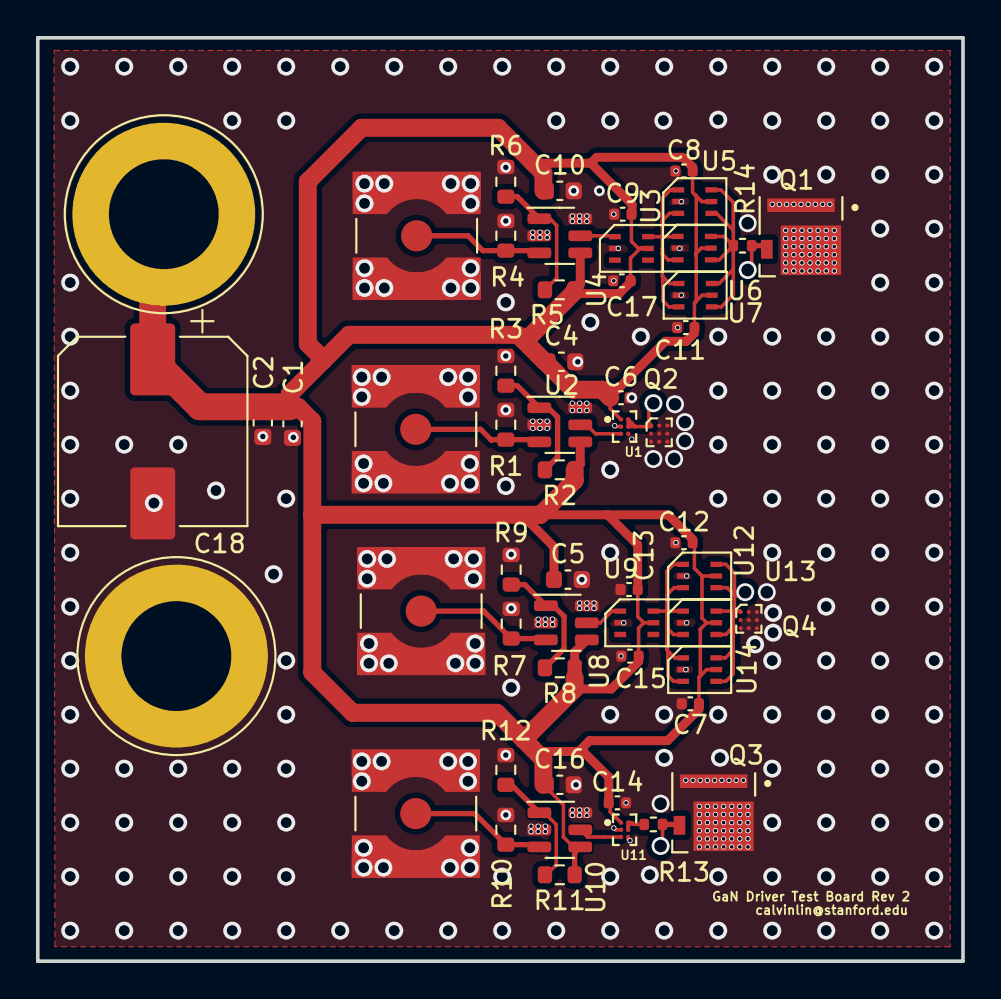
[picture p29: board GD_test.kicad_pcb from above]

Board: 2 copper layers, 51.4 x 51.3 mm, 55 parts (0 on the bottom side), 22 nets.

Parts:
C1, C2, C4, C5, C10, C16: C_Small; C_0603_1608Metric
C6, C7, C8, C9, C11, C12, C13, C14, C15, C17: C_Small; C_0402_1005Metric
C18: C_Small; CP_Elec_10x10
J1, J2, J3, J4: RF_IN; SMA_Amphenol_132134-10_Vertical
J5, J6: Conn_01x01_Pin; Banana_Jack_1Pin
Q1, Q3: GS61004B-MR; TRANS_GS61004B-MR
Q2, Q4: EPC2214; BGA-9_3x3_6.0x6.0mm
R1, R4, R7, R10: 50; R_0603_1608Metric
R2, R5, R8, R11: OPEN; R_0603_1608Metric
R3, R6, R9, R12: SHORT; R_0603_1608Metric
R13, R14: 1; R_0402_1005Metric
U1, U11: LMG1020YFF; BGA6N40P3X2_125X85X62N
U2, U4, U8, U10: TLV3501; SOT-23-6
U3, U5, U6, U7, U9, U12, U13, U14: NC7WZ04; nc7wz04_sc-88_SOIC-6

Connections:
+5V: C1.1, C2.1, C4.1, C5.1, C6.1, C7.1, C8.2, C9.2, C10.1, C11.2, C12.2, C13.2, C14.1, C15.2, C16.1, C17.1, C18.1, J5.1, R2.1, R5.1, R8.1, R11.1, U1.A1 (V_{DD}), U2.4 (V+), U3.5 (VCC), U4.4 (V+), U5.5 (VCC), U6.5 (VCC), U7.5 (VCC), U8.4 (V+), U9.5 (VCC), U10.4 (V+), U11.A1 (V_{DD}), U12.5 (VCC), U13.5 (VCC), U14.5 (VCC)
/RF_IN_1: J1.1 (In), R1.2, U2.3 (+IN)
/RF_IN_2: J4.1 (In), R4.2, U4.3 (+IN)
/RF_IN_3: J2.1 (In), R7.2, U8.3 (+IN)
/RF_IN_4: J3.1 (In), R10.2, U10.3 (+IN)
/inv_out: U9.6 (Y1), U12.1 (A1), U12.3 (A2), U13.1 (A1), U13.3 (A2), U14.1 (A1), U14.3 (A2)
GND: C1.2, C2.2, C4.2, C5.2, C6.2, C7.2, C8.1, C9.1, C10.2, C11.1, C12.1, C13.1, C14.2, C15.1, C16.2, C17.2, C18.2, J1.2 (Ext), J2.2 (Ext), J3.2 (Ext), J4.2 (Ext), J6.1, Q1.1, Q1.3, Q2.2 (S), Q2.3 (S), Q2.4 (D), Q2.5 (D), Q2.6 (D), Q2.7 (D), Q2.8 (S), Q2.9 (S), Q3.1, Q3.3, Q4.2 (S), Q4.3 (S), Q4.4 (D), Q4.5 (D), Q4.6 (D), Q4.7 (D), Q4.8 (S), Q4.9 (S), R1.1, R3.2, R4.1, R6.2, R7.1, R9.2, R10.1, R12.2, U1.B1 (GND), U1.C2 (IN-), U2.2 (V-), U2.6 (SHDN), U3.2 (GND), U4.2 (V-), U4.6 (SHDN), U5.2 (GND), U6.2 (GND), U7.2 (GND), U8.2 (V-), U8.6 (SHDN), U9.2 (GND), U10.2 (V-), U10.6 (SHDN), U11.B1 (GND), U11.C2 (IN-), U12.2 (GND), U13.2 (GND), U14.2 (GND)
unnamed: Q1.2, R14.2
unnamed: Q2.1 (G), U1.A2 (OUTH), U1.B2 (OUTL)
unnamed: Q3.2, R13.2
unnamed: Q4.1 (G), U12.4 (Y2), U12.6 (Y1), U13.4 (Y2), U13.6 (Y1), U14.4 (Y2), U14.6 (Y1)
unnamed: U1.C1 (IN+), U2.5 (OUT)
unnamed: R2.2, R3.1, U2.1 (-IN)
unnamed: U3.1 (A1), U4.5 (OUT)
unnamed: U3.6 (Y1), U5.1 (A1), U5.3 (A2), U6.1 (A1), U6.3 (A2), U7.1 (A1), U7.3 (A2)
unnamed: R5.2, R6.1, U4.1 (-IN)
unnamed: R14.1, U5.4 (Y2), U5.6 (Y1), U6.4 (Y2), U6.6 (Y1), U7.4 (Y2), U7.6 (Y1)
unnamed: R8.2, R9.1, U8.1 (-IN)
unnamed: U8.5 (OUT), U9.1 (A1)
unnamed: R11.2, R12.1, U10.1 (-IN)
unnamed: U10.5 (OUT), U11.C1 (IN+)
unnamed: R13.1, U11.A2 (OUTH), U11.B2 (OUTL)
