calvinhlin/IMSSDC2024/(commit log)

2024-02-17 imssdc 2024 first commit
    [GD_test.kicad_pcb, GD_test.kicad_sch]
2024-02-20 gate driver board
    [GD_test.kicad_pcb, GD_test.kicad_sch]
2024-02-20 gate driver gerbers and some extra changes
    [GD_test-B_Cu.gbr, GD_test-B_Mask.gbr, GD_test-B_Paste.gbr, GD_test-B_Silkscreen.gbr, GD_test-Edge_Cuts.gbr, GD_test-F_Cu.gbr, GD_test-F_Mask.gbr, GD_test-F_Paste.gbr]
2024-02-21 gate driver stuff
2024-02-21 gate driver test board changes
    [GD_test-B_Cu.gbr, GD_test-B_Mask.gbr, GD_test-B_Paste.gbr, GD_test-B_Silkscreen.gbr, GD_test-Edge_Cuts.gbr, GD_test-F_Cu.gbr, GD_test-F_Mask.gbr, GD_test-F_Paste.gbr]
2024-03-07 gate driver testboard rev 3 stuff
    [GD_test.kicad_pcb, GD_test.kicad_sch, phi2_50MHz_EPC2214.kicad_pcb, phi2_50MHz_EPC2214.kicad_sch]
2024-03-11 gate driver rev 3 updates
2024-03-13 gate driver test board rev 2 gerbers commit
    [GD_test-B_Cu.gbr, GD_test-B_Mask.gbr, GD_test-B_Paste.gbr, GD_test-B_Silkscreen.gbr, GD_test-Edge_Cuts.gbr, GD_test-F_Cu.gbr, GD_test-F_Mask.gbr, GD_test-F_Paste.gbr]
2024-04-03 some progress on 50 MHz design
    [phi2_50MHz_EPC2214.kicad_sch]
2024-04-04 small schem progress
    [phi2_50MHz_EPC2214.kicad_sch]
2024-04-07 mostly finalized schematic stuff for student design board
    [phi2_50MHz_EPC2214.kicad_pcb, phi2_50MHz_EPC2214.kicad_sch]
2024-04-09 rough draft of phi 2 board
    [phi2_50MHz_EPC2214.kicad_pcb, phi2_50MHz_EPC2214.kicad_sch]
2024-04-09 deleted some vias
    [phi2_50MHz_EPC2214.kicad_pcb]
2024-04-10 gerbers and rev1 board sent out
    [phi2_50MHz_EPC2214-B_Cu.gbr, phi2_50MHz_EPC2214-B_Mask.gbr, phi2_50MHz_EPC2214-B_Paste.gbr, phi2_50MHz_EPC2214-B_Silkscreen.gbr, phi2_50MHz_EPC2214-Edge_Cuts.gbr, phi2_50MHz_EPC2214-F_Cu.gbr, phi2_50MHz_EPC2214-F_Mask.gbr, phi2_50MHz_EPC2214-F_Paste.gbr]
2024-04-10 added width to drain trace, now sent out board
    [phi2_50MHz_EPC2214-B_Cu.gbr, phi2_50MHz_EPC2214-B_Mask.gbr, phi2_50MHz_EPC2214-B_Paste.gbr, phi2_50MHz_EPC2214-B_Silkscreen.gbr, phi2_50MHz_EPC2214-Edge_Cuts.gbr, phi2_50MHz_EPC2214-F_Cu.gbr, phi2_50MHz_EPC2214-F_Mask.gbr, phi2_50MHz_EPC2214-F_Paste.gbr]
2024-04-12 idk what i changed here
    [phi2_50MHz_EPC2214.kicad_sch]
2024-04-17 kicad changes if i ever make a new board
    [phi2_50MHz_EPC2214.kicad_pcb, phi2_50MHz_EPC2214.kicad_sch]
2024-04-24 matching network changes to ims design
    [phi2_50MHz_EPC2214.kicad_sch]
2024-04-27 ims changes
    [ZOUT.CSV, phi2_50MHz_EPC2214.kicad_pcb]
2024-05-02 added report
    [phi2_50MHz_EPC2214.csv, phi2_50MHz_EPC2214.kicad_sch]
2024-05-03 experimental data
    [ims24drain_withbuck.csv, ims24drainsource.csv, ims24gate.csv, ims24output.csv]
2024-05-06 layout and gerbers with new epc device
    [ims24drain.csv, ims24drain_withbuck.csv, ims24drainsource.csv, ims24gate.csv, ims24output.csv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]
2024-05-08 epc 8010 new board gerbers
    [phi2_50MHz_EPC8010-B_Cu.gbr, phi2_50MHz_EPC8010-B_Mask.gbr, phi2_50MHz_EPC8010-B_Paste.gbr, phi2_50MHz_EPC8010-B_Silkscreen.gbr, phi2_50MHz_EPC8010-Edge_Cuts.gbr, phi2_50MHz_EPC8010-F_Cu.gbr, phi2_50MHz_EPC8010-F_Mask.gbr, phi2_50MHz_EPC8010-F_Paste.gbr]
2024-05-31 added measurement data
    [ims24drain_rev1.csv, ims24drain_rev2.csv, ims24gate_rev1.csv, ims24gate_rev2.csv, ims24output_rev1.csv, ims24output_rev2.csv, ims24spectrum_rev2.csv, thermal_pixels.csv]
2024-06-06 checking output network
    [ims24output_rev2.csv]
2024-09-06 lots of figures for magazine paper
    [ims24gate_rev2.csv, ims24output_rev1.csv, ims24spectrum_rev2.csv]
2024-09-06 figures for microwave paper
    [thermal_pixels.csv]
